davidwwhitney1-lgtm/disctracker/hardware/cad/renders/v_cover.png

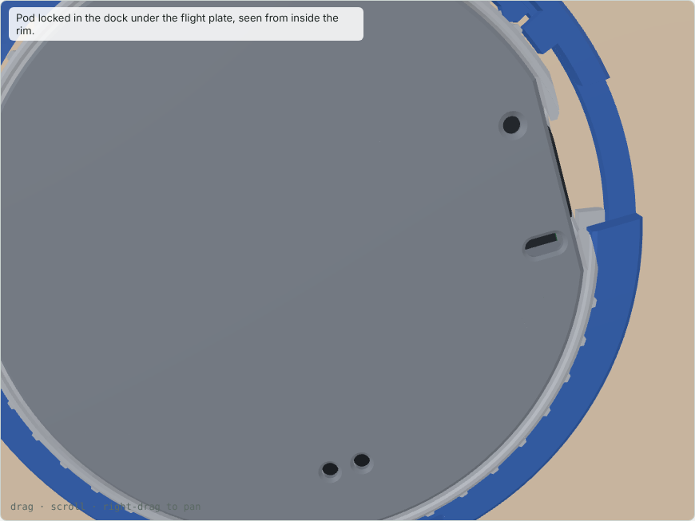
hardware/cad/renders/v_cover.png
