davidwwhitney1-lgtm/disctracker/hardware/cad/renders/v_exploded.png

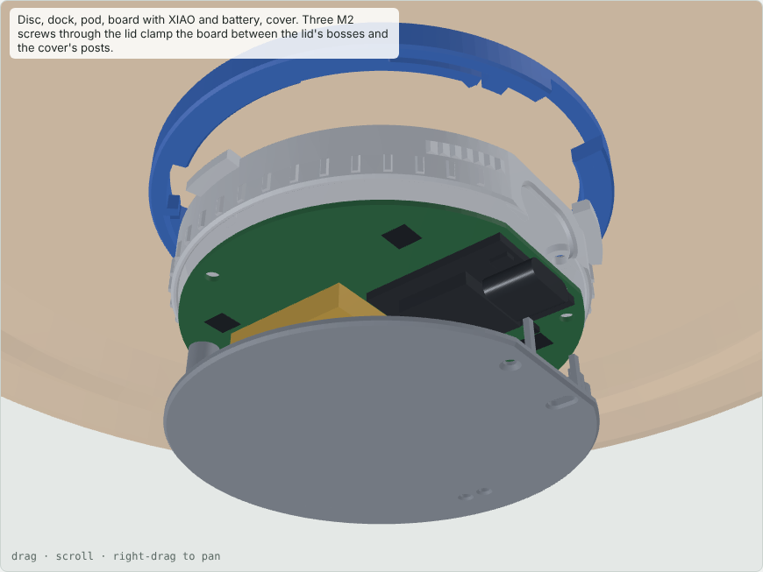
hardware/cad/renders/v_exploded.png
