davidwwhitney1-lgtm/disctracker/hardware/cad/renders/v_finger.png

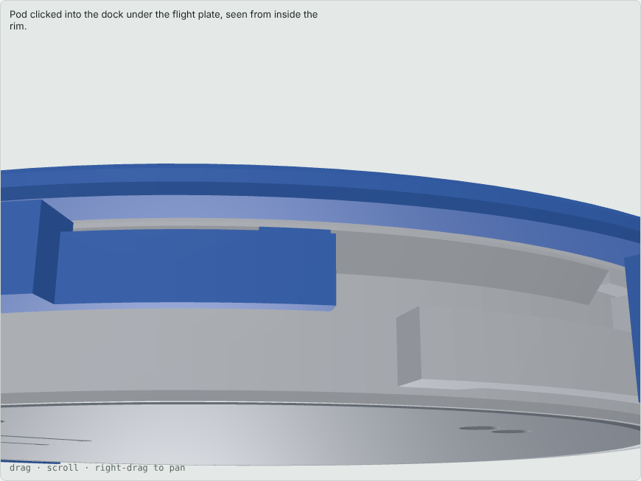
hardware/cad/renders/v_finger.png
