davidwwhitney1-lgtm/disctracker/hardware/cad/renders/v_jig.png

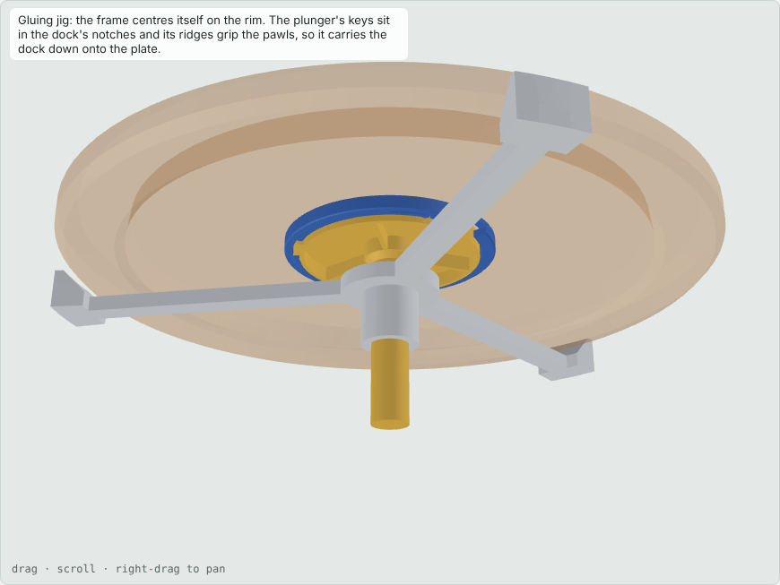
hardware/cad/renders/v_jig.png
