davidwwhitney1-lgtm/disctracker/hardware/cad/renders/v_latch.png

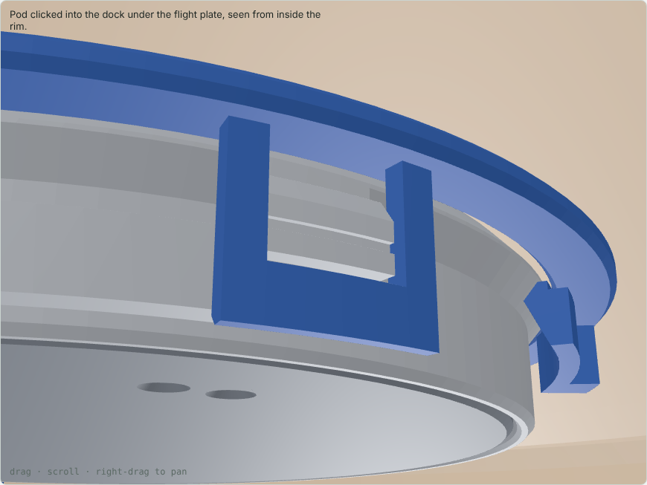
hardware/cad/renders/v_latch.png
