davidwwhitney1-lgtm/disctracker/hardware/cad/renders/v_lock.png

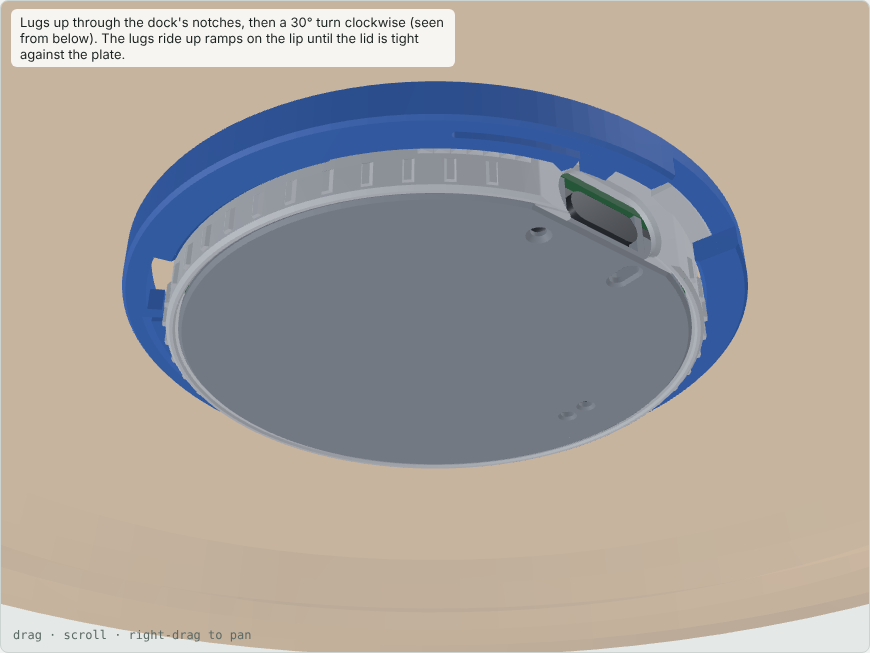
hardware/cad/renders/v_lock.png
