davidwwhitney1-lgtm/disctracker/hardware/cad/renders/v_lug_section.png

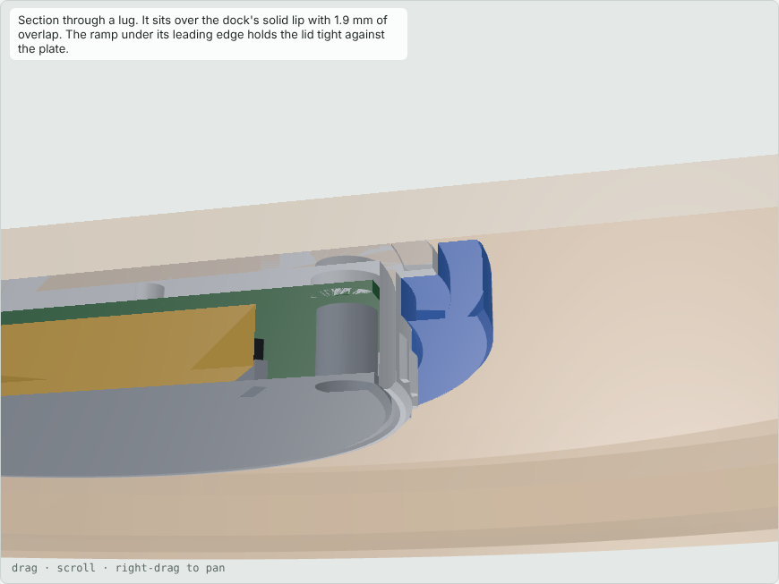
hardware/cad/renders/v_lug_section.png
