davidwwhitney1-lgtm/disctracker/hardware/cad/renders/v_reset_section.png

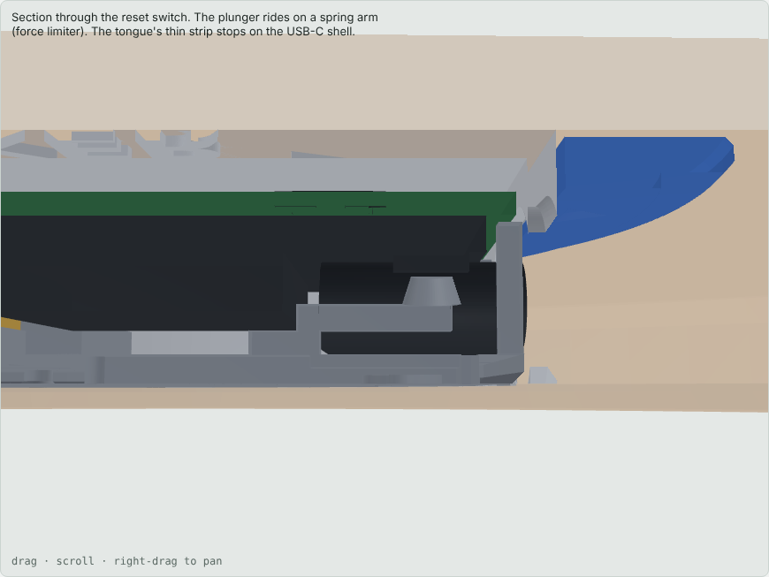
hardware/cad/renders/v_reset_section.png
