davidwwhitney1-lgtm/disctracker/hardware/cad/renders/v_usb_end.png

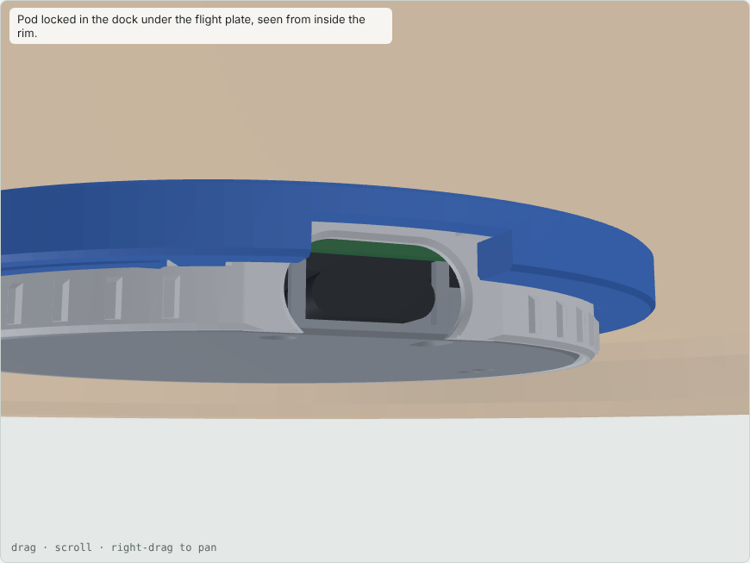
hardware/cad/renders/v_usb_end.png
