davidwwhitney1-lgtm/disctracker/hardware/cad/renders/v_usb_section.png

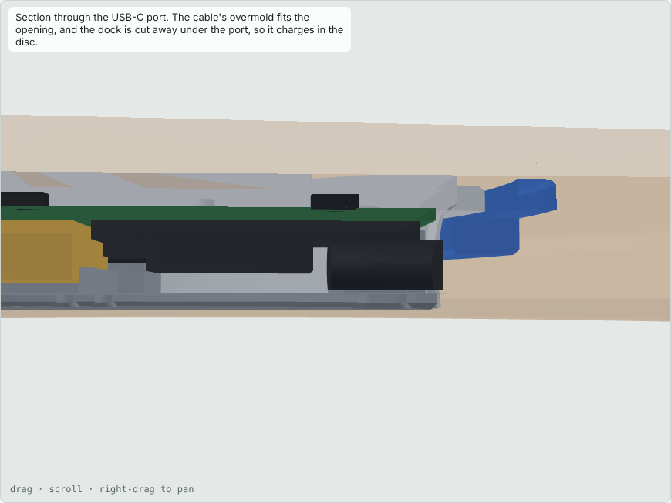
hardware/cad/renders/v_usb_section.png
