davidwwhitney1-lgtm/disctracker/hardware/kicad/fab/render_3d_bottom.png

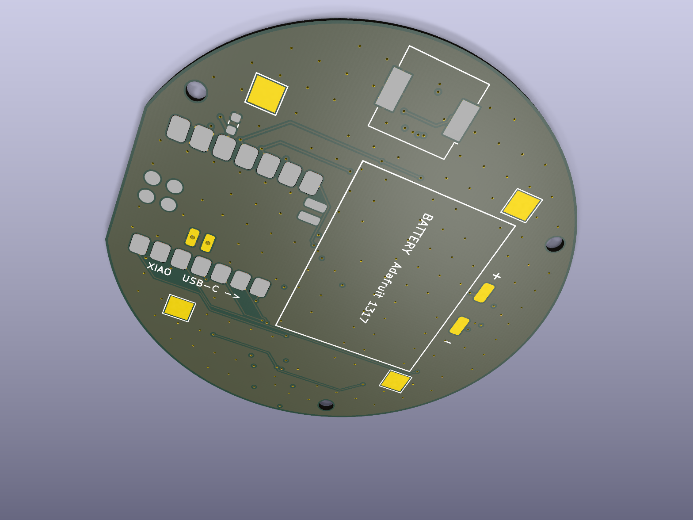
hardware/kicad/fab/render_3d_bottom.png
