davidwwhitney1-lgtm/disctracker/hardware/kicad/fab/render_3d_top.png

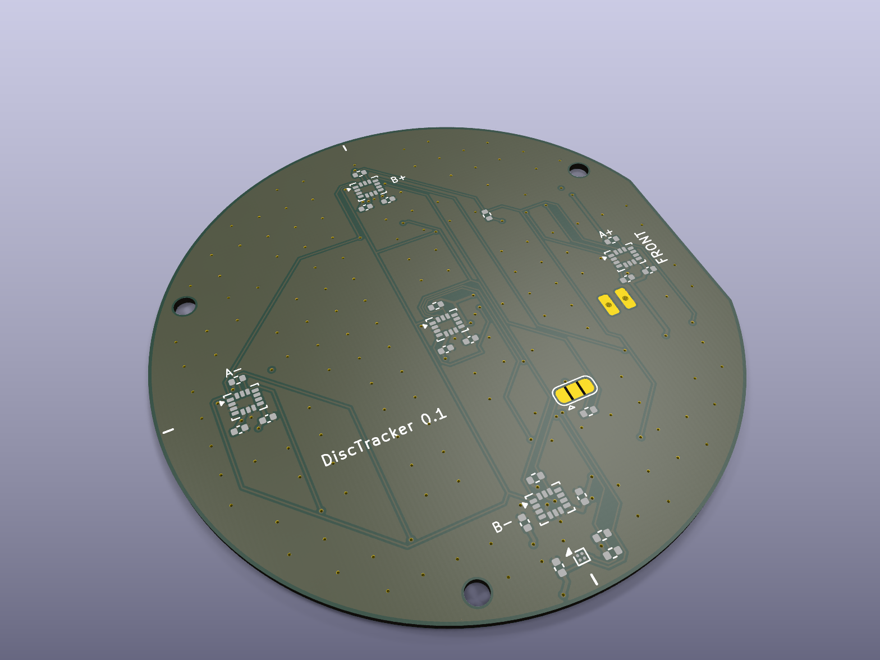
hardware/kicad/fab/render_3d_top.png
