davidwwhitney1-lgtm/disctracker/hardware/kicad/fab/render_sensor_face.png

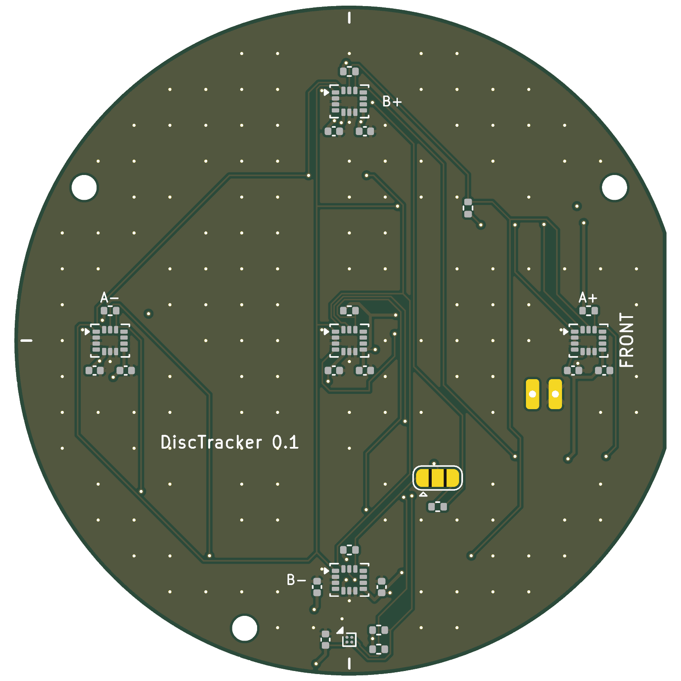
hardware/kicad/fab/render_sensor_face.png
