davidwwhitney1-lgtm/disctracker/hardware/kicad/fab/render_xiao_face.png

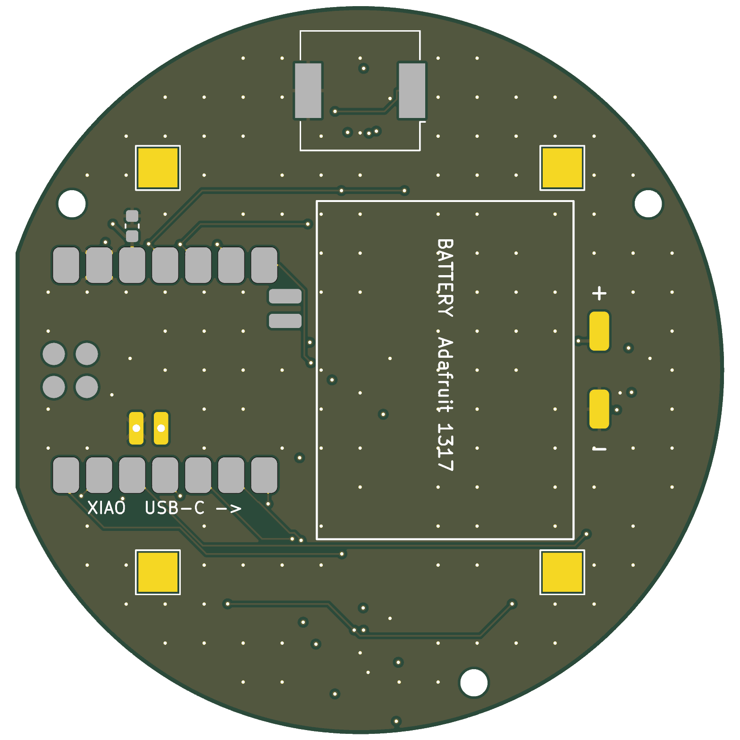
hardware/kicad/fab/render_xiao_face.png
