davidwwhitney1-lgtm/disctracker/hardware/bom.csv

Ref | Part | Value | Package | Qty | Populate | Face | Notes
U1 | ST LSM6DSV320X |  | LGA-14 2.5x3.0x0.83 | 1 | Yes | Sensor | Center IMU
U2 | ST LSM6DSV320X |  | LGA-14 2.5x3.0x0.83 | 1 | Yes | Sensor | Spin pair A (+20.00; 0)
U3 | ST LSM6DSV320X |  | LGA-14 2.5x3.0x0.83 | 1 | Yes | Sensor | Spin pair A (-20.00; 0)
U4 | ST LSM6DSV320X |  | LGA-14 2.5x3.0x0.83 | 1 | DNP | Sensor | Spin pair B (0; +20.00)
U5 | ST LSM6DSV320X |  | LGA-14 2.5x3.0x0.83 | 1 | DNP | Sensor | Spin pair B (0; -20.00)
U6 | MEMSIC MMC5603NJ |  | WLCSP 0.8x0.8 | 1 | Yes | Sensor | Magnetometer at (0; -24); JLCPCB C404328; I2C 0x30
C1-C10 | Capacitor | 100 nF | 0402 | 10 | 6 of 10 | Sensor | VDD (pin 8) + VDDIO (pin 5) per IMU; C7-C10 DNP with U4/U5
C11 | Capacitor | 2.2 uF | 0402 | 1 | Yes | Sensor | Magnetometer VDD (datasheet minimum 2.2 uF)
C12 | Capacitor | 10 uF | 0603 | 1 | Yes | XIAO | Bulk at XIAO 3V3
R1 R2 | Resistor | 4.7 k | 0402 | 2 | Yes | Sensor | I2C pull-ups (magnetometer)
R3 | Resistor | 33 R | 0402 | 1 | Yes | Sensor | Series on SPI clock
R4-R8 | Resistor | 100 k | 0402 | 5 | Yes | Sensor | CS pull-ups to 3V3 (firmware disables chips' internal pull-up with I2C_I3C_disable)
M1 | Seeed XIAO nRF52840 Sense |  | castellated SMD | 1 | Yes | XIAO | 2.027 g / 4.0 mm (measured); center (+15; 0) so USB-C reaches the pod edge; hand-soldered
BZ1 | CUI CPT-9019S-SMT-TR |  | 9x9x1.9 SMD | 1 | Yes | XIAO | Piezo 3 V / 5 mA / 65 dB @10 cm / 4 kHz; JLCPCB C95163; at (0; +21.5)
JP1 | 3-pad solder jumper |  | SMD | 1 | Yes | XIAO | D6 -> A: U5 CS / B: BZ1; ship bridged to B
R9 | Resistor | 100 R | 0402 | 1 | Yes | Sensor | Series to buzzer (limits peak current into piezo)
H1-H3 | Mounting hole | 2.1 mm | NPTH | 3 | - | Both | Alignment pins; r = 25.6 mm at 30/150/250 deg
BT1 | Adafruit 1317 LiPo 3.7 V (protected) | 150 mAh | 19.75x26.02x3.8 mm | 1 | Yes | XIAO | 4.65 g; center (-6.54; 0); bonded down; leads cut short to J1/J2; charge at 100 mA
J1 J2 | Battery pads |  | pads | 2 | Yes | XIAO | At (-18.4; +/-3); routed to XIAO BAT pads
TP1-TP4 | Balance trim pads | 3x3 mm | copper pad | 4 | Yes | XIAO | +X/-X/+Y/-Y; -Y opposite the buzzer; add solder to trim
