davidwwhitney1-lgtm/disctracker/hardware/kicad/fab/bom_jlc.csv

Comment | Designator | Footprint | LCSC Part #
100n | C1,C2,C3,C4,C5,C6 | C_0402_1005Metric | C1525
2.2u | C11 | C_0402_1005Metric | C12530
4.7k | R1,R2 | R_0402_1005Metric | C25900
33 | R3 | R_0402_1005Metric | C25105
100k | R4,R5,R6 | R_0402_1005Metric | C25741
100 | R9 | R_0402_1005Metric | C25076
LSM6DSV320X | U1,U2,U3 | LGA-14_3x2.5mm_P0.5mm_LayoutBorder3x4y
MMC5603NJ | U6 | WLP-4_0.86x0.86mm_P0.4mm | C404328
