davidwwhitney1-lgtm/disctracker/hardware/placement.csv

Ref | X_mm | Y_mm | Rotation | Face | Populate | Role
U1 | 0.00 | 0.00 | 0 | Sensor | Yes | Center IMU
U2 | 20.00 | 0.00 | 0 | Sensor | Yes | Pair A (+X)
U3 | -20.00 | 0.00 | 0 | Sensor | Yes | Pair A (-X)
U4 | 0.00 | 20.00 | 0 | Sensor | DNP | Pair B (+Y)
U5 | 0.00 | -20.00 | 0 | Sensor | DNP | Pair B (-Y)
U6 | 0.00 | -25.00 | 0 | Sensor | Yes | Magnetometer (moved 0.8 mm down for routing room; >=10 mm from XIAO and battery)
M1 | 15.00 | 0.00 | 0 | XIAO | Yes | XIAO (offset TBD by USB-C notch and balance)
BT1 | -6.54 | 0.00 | 0 | XIAO | Yes | Adafruit 1317 (19.75 in X x 26.02 in Y); balances XIAO 2.027 g at +15
J1 | -18.40 | 3.00 | 0 | XIAO | Yes | BAT+ pad
J2 | -18.40 | -3.00 | 0 | XIAO | Yes | BAT- pad
BZ1 | 0.00 | 21.50 | 0 | XIAO | Yes | Buzzer
TP1 | 0.00 | -21.50 | 0 | XIAO | Yes | Balance trim
C9 | 2.70 | -20.60 | 90 | Sensor | DNP | U5 VDD cap beside the chip (frees space for U6)
C10 | -2.70 | -20.60 | 90 | Sensor | DNP | U5 VDDIO cap beside the chip
H1-H3 | r=25.6 | 30/150/250 deg | - | Both | - | 2.1 mm NPTH alignment holes
TP1-TP4 | r=22 | 45/135/225/315 deg | - | XIAO | - | 3x3 mm balance trim pads
