davidwwhitney1-lgtm/disctracker/hardware/pinmap.csv

XIAO_pin | nRF_pin | Net | Goes_to | Notes
3V3 |  | +3V3 | IMU pin 8 VDD + pin 5 VDDIO; U6 B1; R1 R2 R4-R8; C12
GND |  | GND | IMU pins 6 7 + pins 2 SDx 3 SCx; U6 A1; plane
D8 | P1.13 | SPI_SCK | IMU pin 13 (SCL/SPC) via R3
D10 | P1.15 | SPI_MOSI | IMU pin 14 (SDA/SDI)
D9 | P1.14 | SPI_MISO | IMU pin 1 (SDO/TA0)
D0 | P0.02 | CS1 | U1 pin 12 | R4 100k pull-up
D1 | P0.03 | CS2 | U2 pin 12 | R5 100k pull-up
D2 | P0.28 | CS3 | U3 pin 12 | R6 100k pull-up
D3 | P0.29 | CS4 | U4 pin 12 | R7 100k pull-up; U4 DNP
D6 | P1.11 | CS5 / BUZZER | JP1: A -> U5 pin 12 / B -> BZ1 | R8 on U5 side; ship bridged to B
D7 | P1.12 | INT1 | U1 pin 4 | Data-ready
D4 | P0.04 | I2C_SDA | U6 B2 + R1
D5 | P0.05 | I2C_SCL | U6 A2 + R2
BAT+/BAT- |  | VBAT | XIAO underside BAT pads -> J1 J2 -> BT1
- |  | NC | IMU pins 9 INT2 / 10 OCS_aux / 11 SDO_aux | Soldered to pad; no connection (datasheet)
