davidwwhitney1-lgtm/disctracker/hardware/cad/out/housing_assembly.step

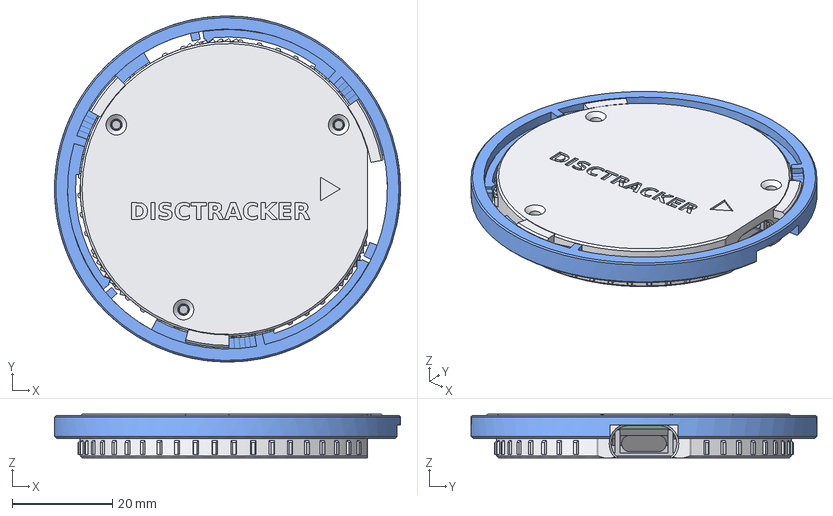
[picture p18: CAD file, 2026-10-14]
hardware/cad/out/housing_assembly.step
69.0 x 69.0 x 8.72 mm
dock
pod
cover
pcb
xiao
parts
battery
