davidwwhitney1-lgtm/disctracker/hardware/cad/out/jig_plunger.step

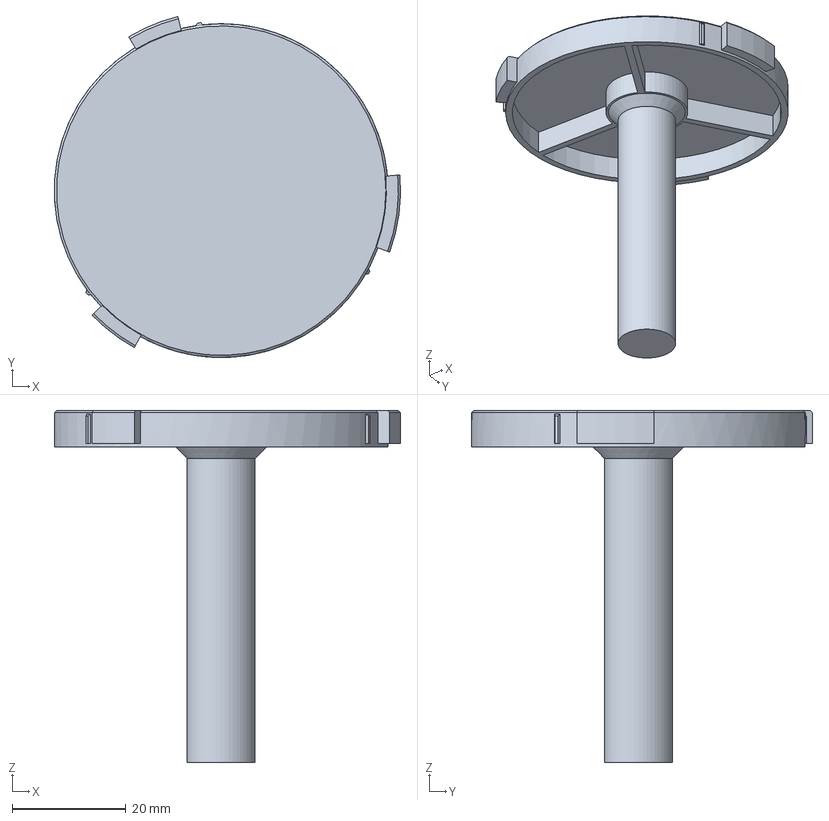
[picture p19: CAD file, 2026-10-14]
hardware/cad/out/jig_plunger.step
61.0 x 60.1 x 62.0 mm
