davidwwhitney1-lgtm/disctracker/hardware/cad/viewer/dock.stl

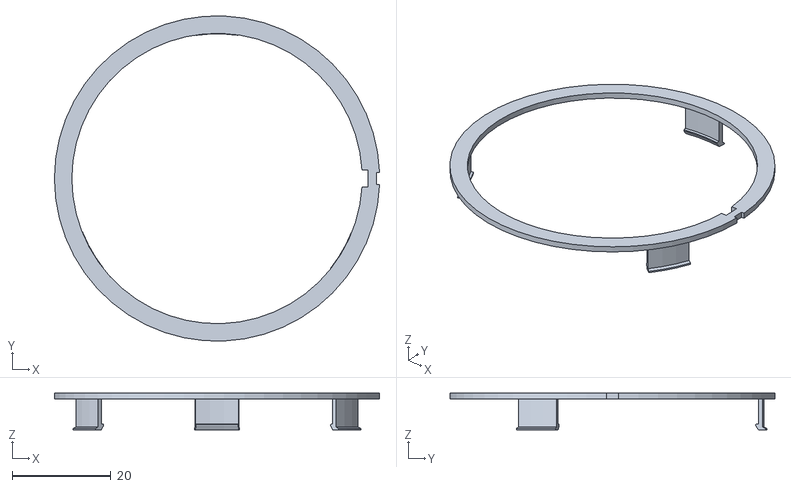
[picture p20: CAD file, 2026-10-10]
hardware/cad/viewer/dock.stl
66.0 x 65.9 x 7.50
