davidwwhitney1-lgtm/disctracker/hardware/kicad/fab/disctracker_sensor.step

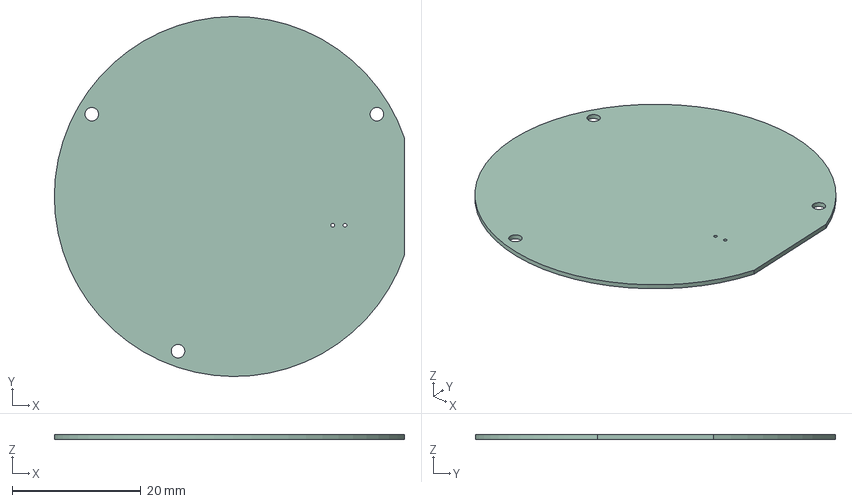
[picture p21: CAD file, 2026-10-09]
hardware/kicad/fab/disctracker_sensor.step
54.5 x 56.0 x 0.71 mm
