davidwwhitney1-lgtm/disctracker/hardware/cad/out/pod.step

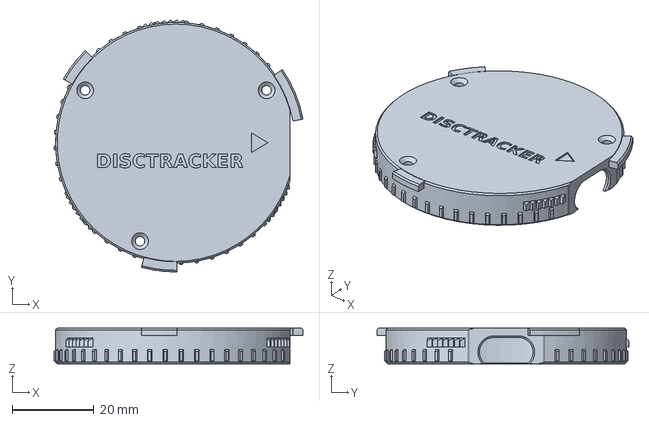
[picture p22: CAD file, 2026-10-14]
hardware/cad/out/pod.step
60.9 x 61.6 x 8.72 mm
