davidwwhitney1-lgtm/disctracker/hardware/cad/viewer/pod.stl

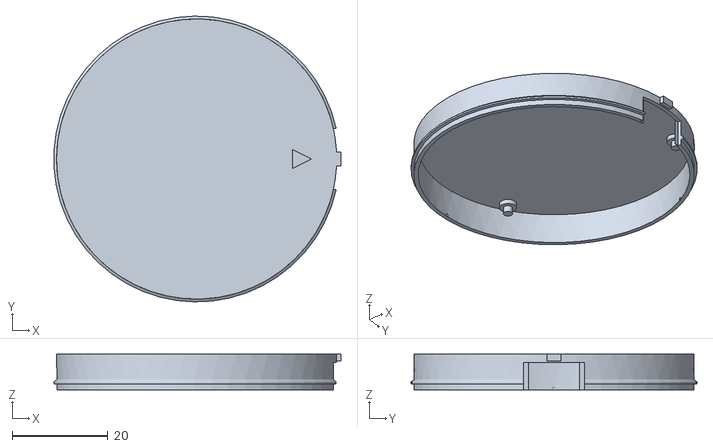
[picture p23: CAD file, 2026-10-10]
hardware/cad/viewer/pod.stl
59.8 x 59.6 x 7.50
