davidwwhitney1-lgtm/disctracker/hardware/cad/out/test_ring.step

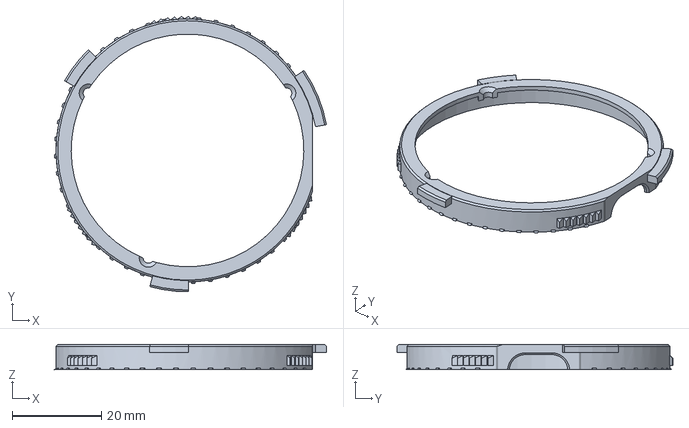
[picture p24: CAD file, 2026-10-14]
hardware/cad/out/test_ring.step
60.8 x 61.6 x 5.60 mm
