davidwwhitney1-lgtm/disctracker/hardware/cad/viewer/cover.stl

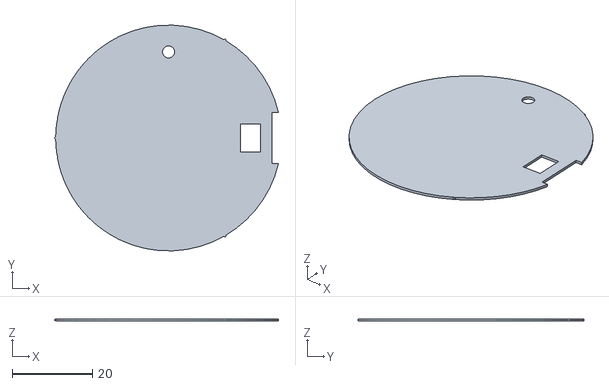
[picture p25: CAD file, 2026-10-10]
hardware/cad/viewer/cover.stl
56.0 x 56.4 x 0.6
