davidwwhitney1-lgtm/disctracker/hardware/cad/out/dock.step

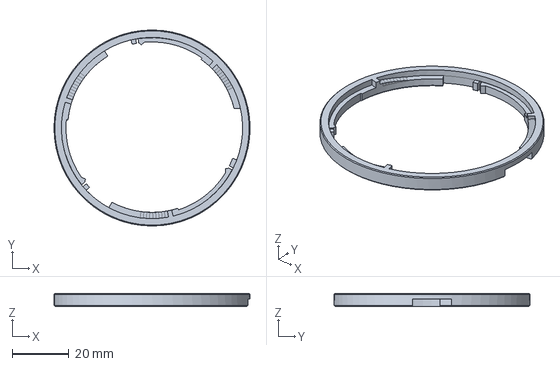
[picture p26: CAD file, 2026-10-14]
hardware/cad/out/dock.step
69.0 x 69.0 x 4.60 mm
