davidwwhitney1-lgtm/disctracker/hardware/cad/viewer/pcb_parts_dummy.stl

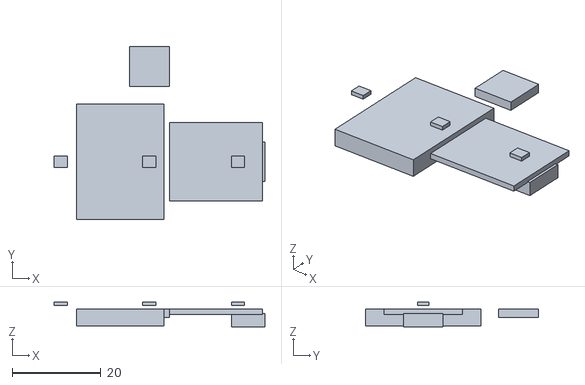
[picture p27: CAD file, 2026-10-10]
hardware/cad/viewer/pcb_parts_dummy.stl
47.6 x 39.0 x 5.63
