davidwwhitney1-lgtm/disctracker/hardware/cad/out/cover.step

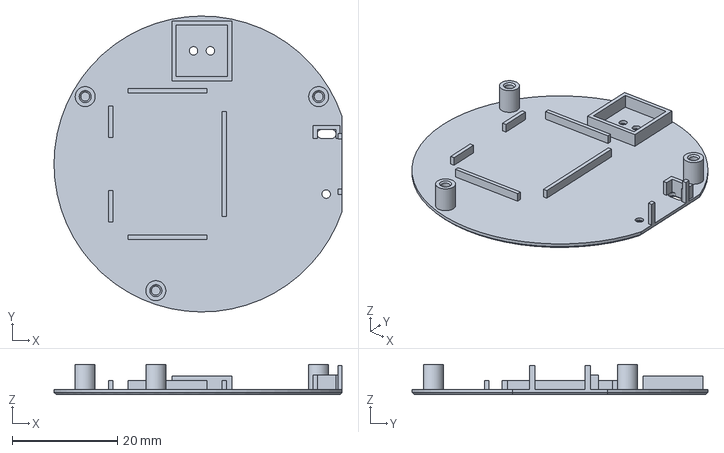
[picture p28: CAD file, 2026-10-14]
hardware/cad/out/cover.step
54.7 x 56.2 x 5.76 mm
