davidwwhitney1-lgtm/disctracker/hardware/cad/viewer/pcb_dummy.stl

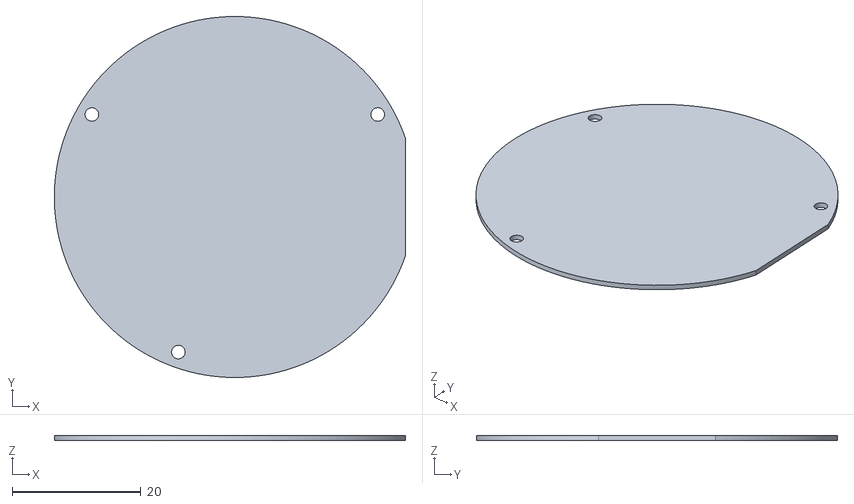
[picture p29: CAD file, 2026-10-10]
hardware/cad/viewer/pcb_dummy.stl
54.5 x 56.0 x 0.8
