davidwwhitney1-lgtm/disctracker/hardware/cad/out/jig_frame.step

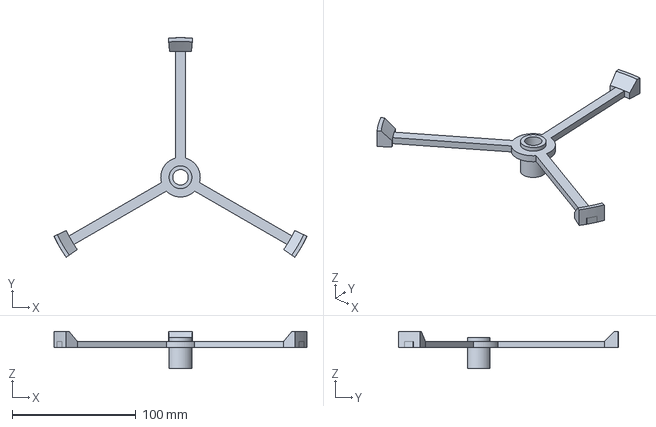
[picture p30: CAD file, 2026-10-14]
hardware/cad/out/jig_frame.step
204.8 x 177.8 x 30.0 mm
