davidwwhitney1-lgtm/disctracker/hardware/cad/out/ref_parts.stl

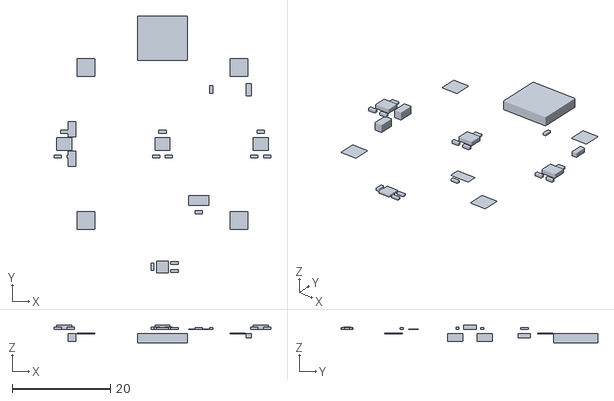
[picture p31: CAD file, 2026-10-11]
hardware/cad/out/ref_parts.stl
44.1 x 52.3 x 3.56
