davidwwhitney1-lgtm/disctracker/hardware/cad/out/ref_disc.stl

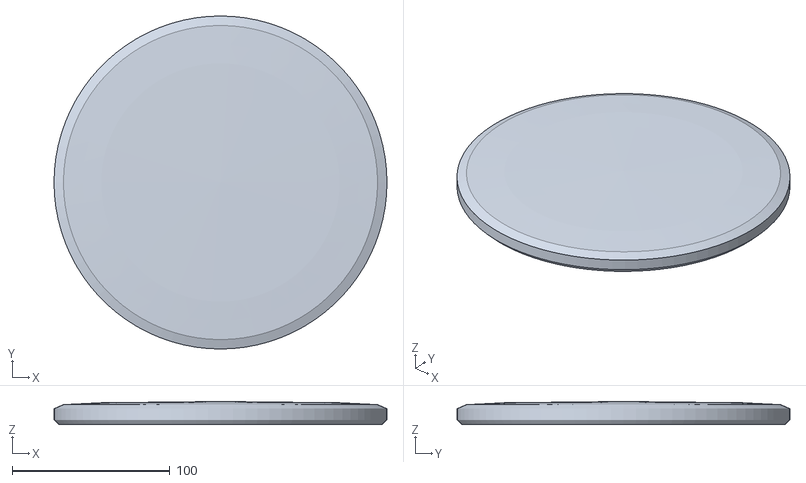
[picture p32: CAD file, 2026-10-11]
hardware/cad/out/ref_disc.stl
211.0 x 211.0 x 14.6
