davidwwhitney1-lgtm/disctracker/hardware/cad/out/ref_battery.stl

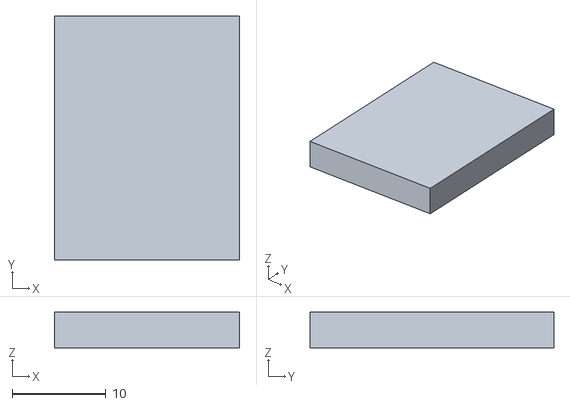
[picture p33: CAD file, 2026-10-11]
hardware/cad/out/ref_battery.stl
19.8 x 26.0 x 3.80
