davidwwhitney1-lgtm/disctracker/hardware/cad/out/ref_xiao.stl

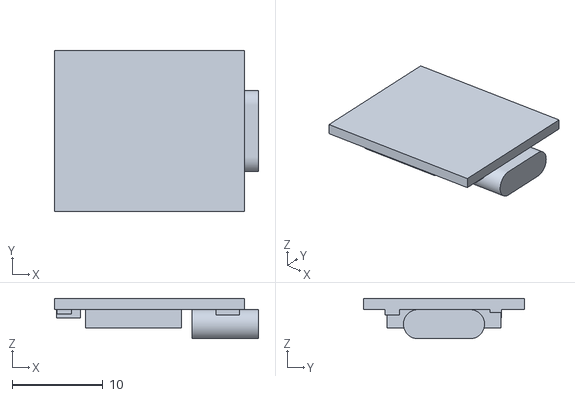
[picture p34: CAD file, 2026-10-11]
hardware/cad/out/ref_xiao.stl
22.5 x 17.8 x 4.46
