davidwwhitney1-lgtm/disctracker/hardware/cad/out/jig.step

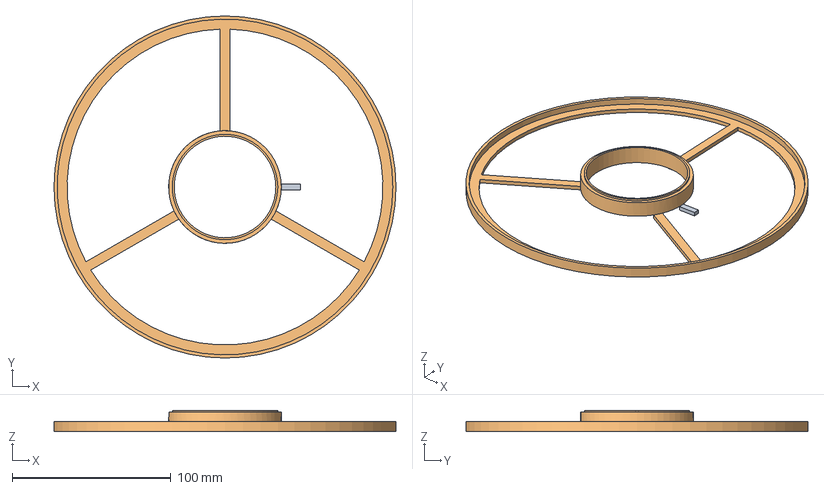
[picture p35: CAD file, 2026-10-10]
hardware/cad/out/jig.step
215.5 x 215.5 x 13.5 mm
