davidwwhitney1-lgtm/disctracker/(list of files, cad)

Other CAD files:
hardware/cad/out/ref_board.stl
hardware/cad/out/cover.stl
hardware/cad/out/dock.stl
hardware/cad/out/jig.stl
hardware/cad/out/jig_frame.stl
hardware/cad/out/jig_plunger.stl
hardware/cad/out/pod.stl
hardware/cad/out/test_ring.stl
