davidwwhitney1-lgtm/disctracker/hardware/cad/renders/v_assembled.png

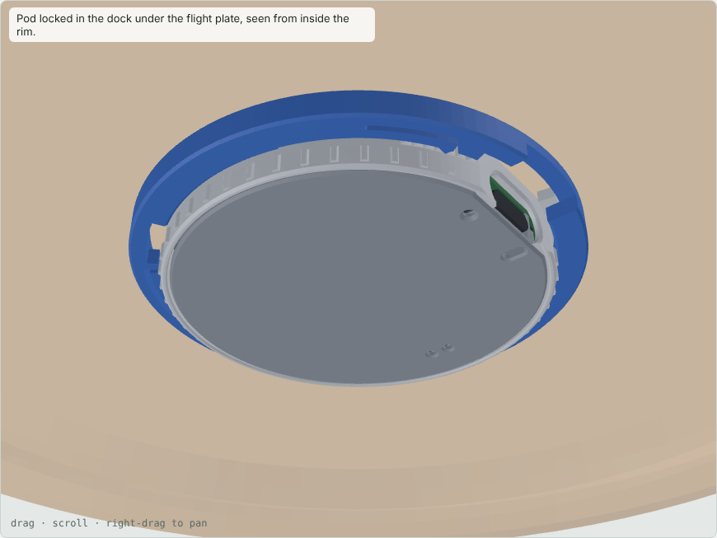
hardware/cad/renders/v_assembled.png
