davidwwhitney1-lgtm/disctracker/hardware/kicad/disctracker_sensor.pdf

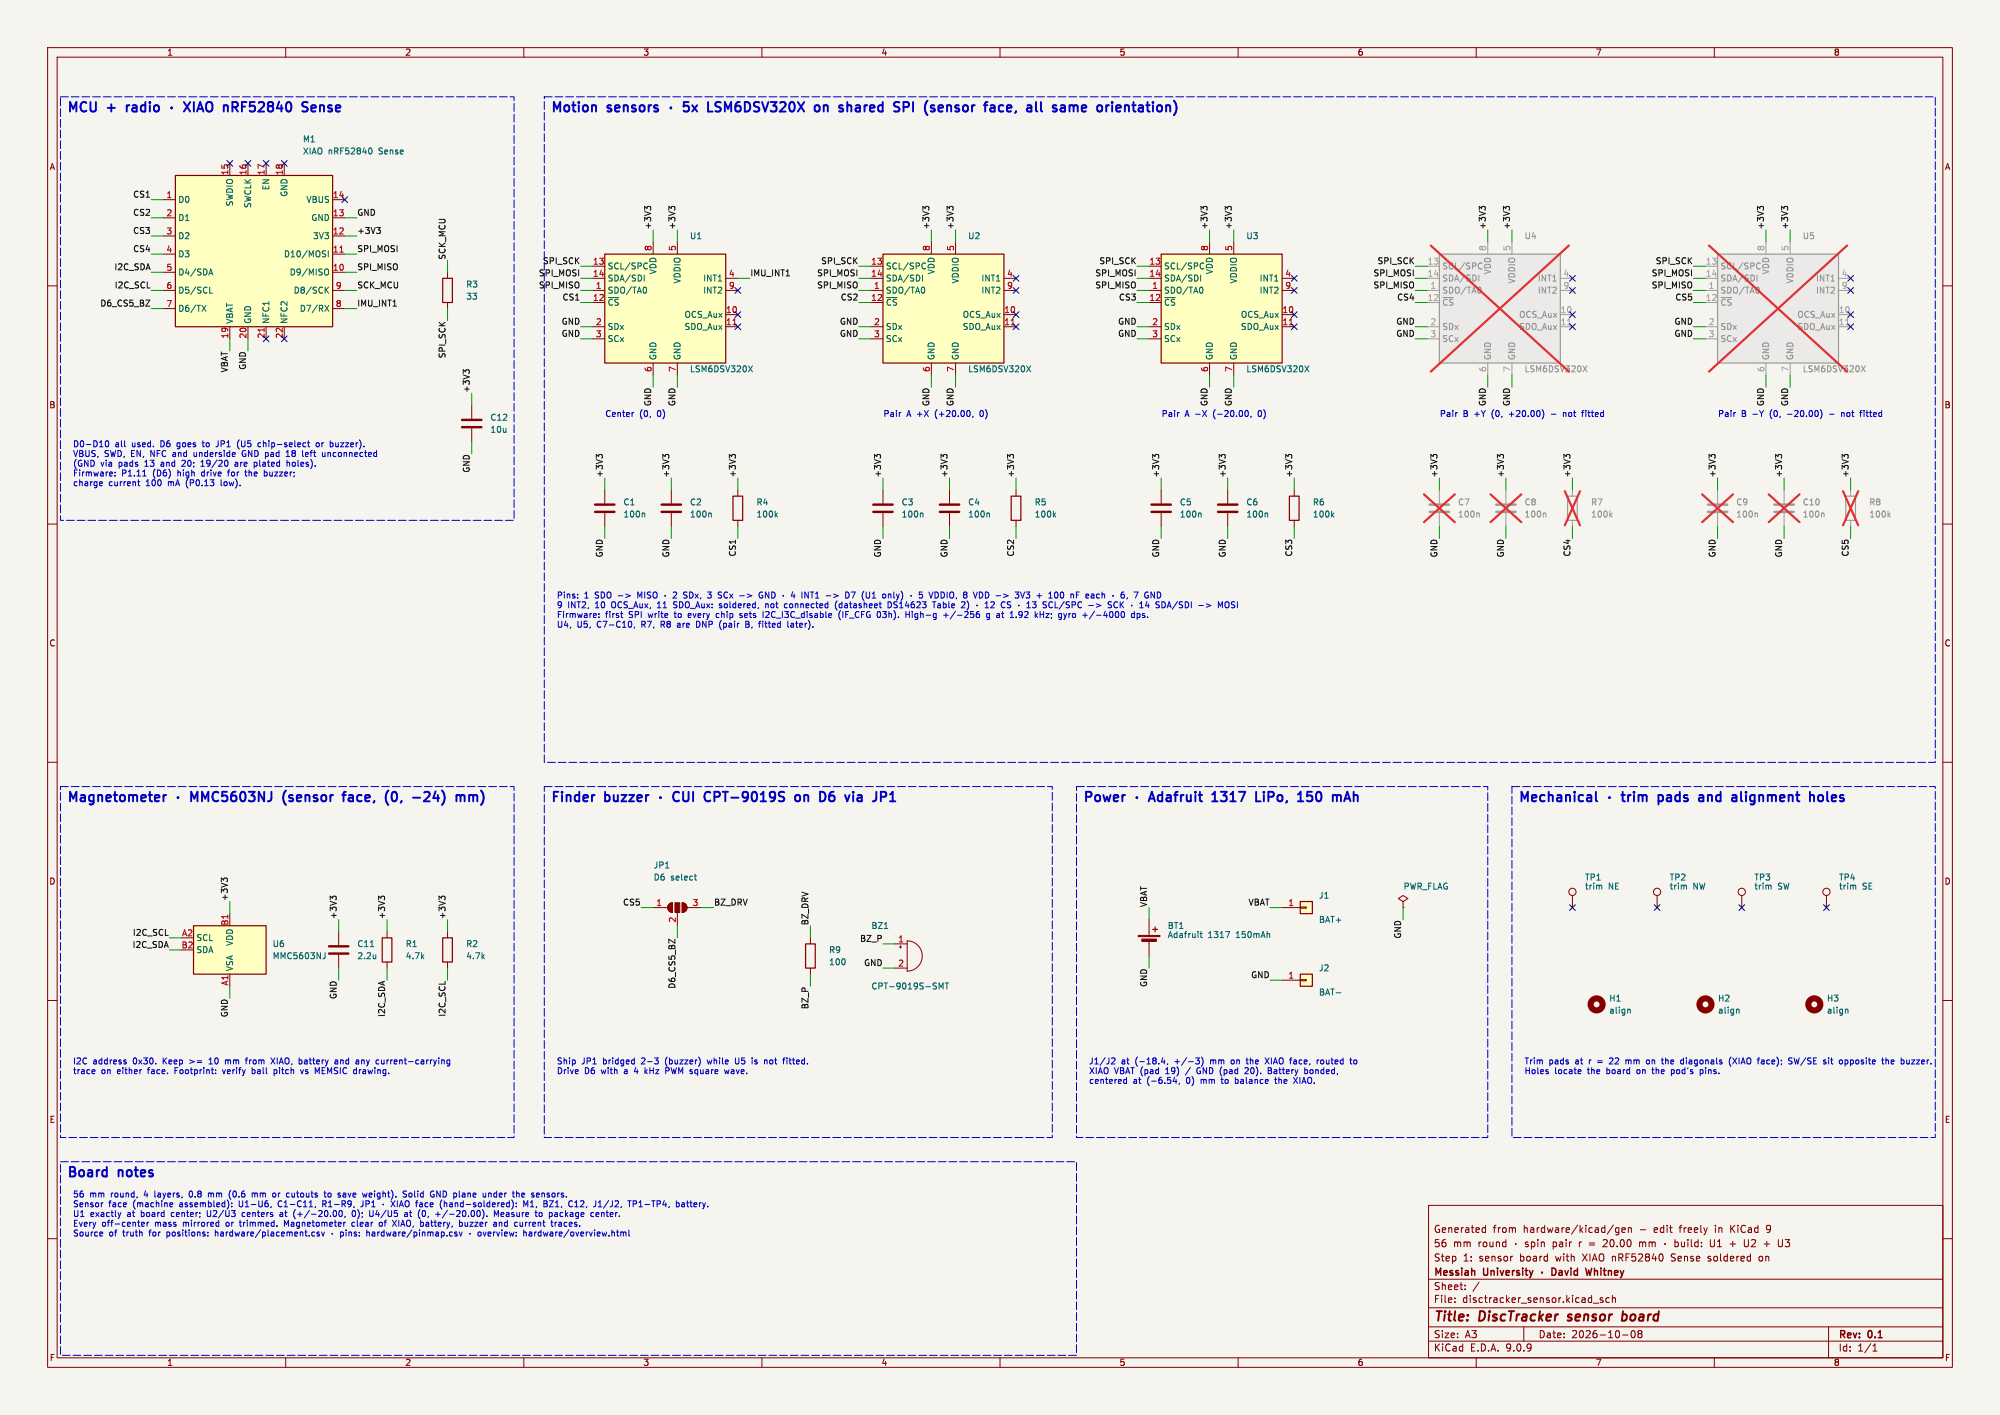
[picture p37: page 1]

Power þÿ·Adafruit 1317 LiPo, 150 mAh

I2C address 0x30. Keep >= 10 mm from XIAO, battery and any current-carrying

Id: 1/1 Title: DiscTracker sensor board
