davidwwhitney1-lgtm/disctracker/hardware/kicad/disctracker_sensor.kicad_pcb

## KiCad design hardware/kicad/disctracker_sensor.kicad_pcb (2026-10-09)

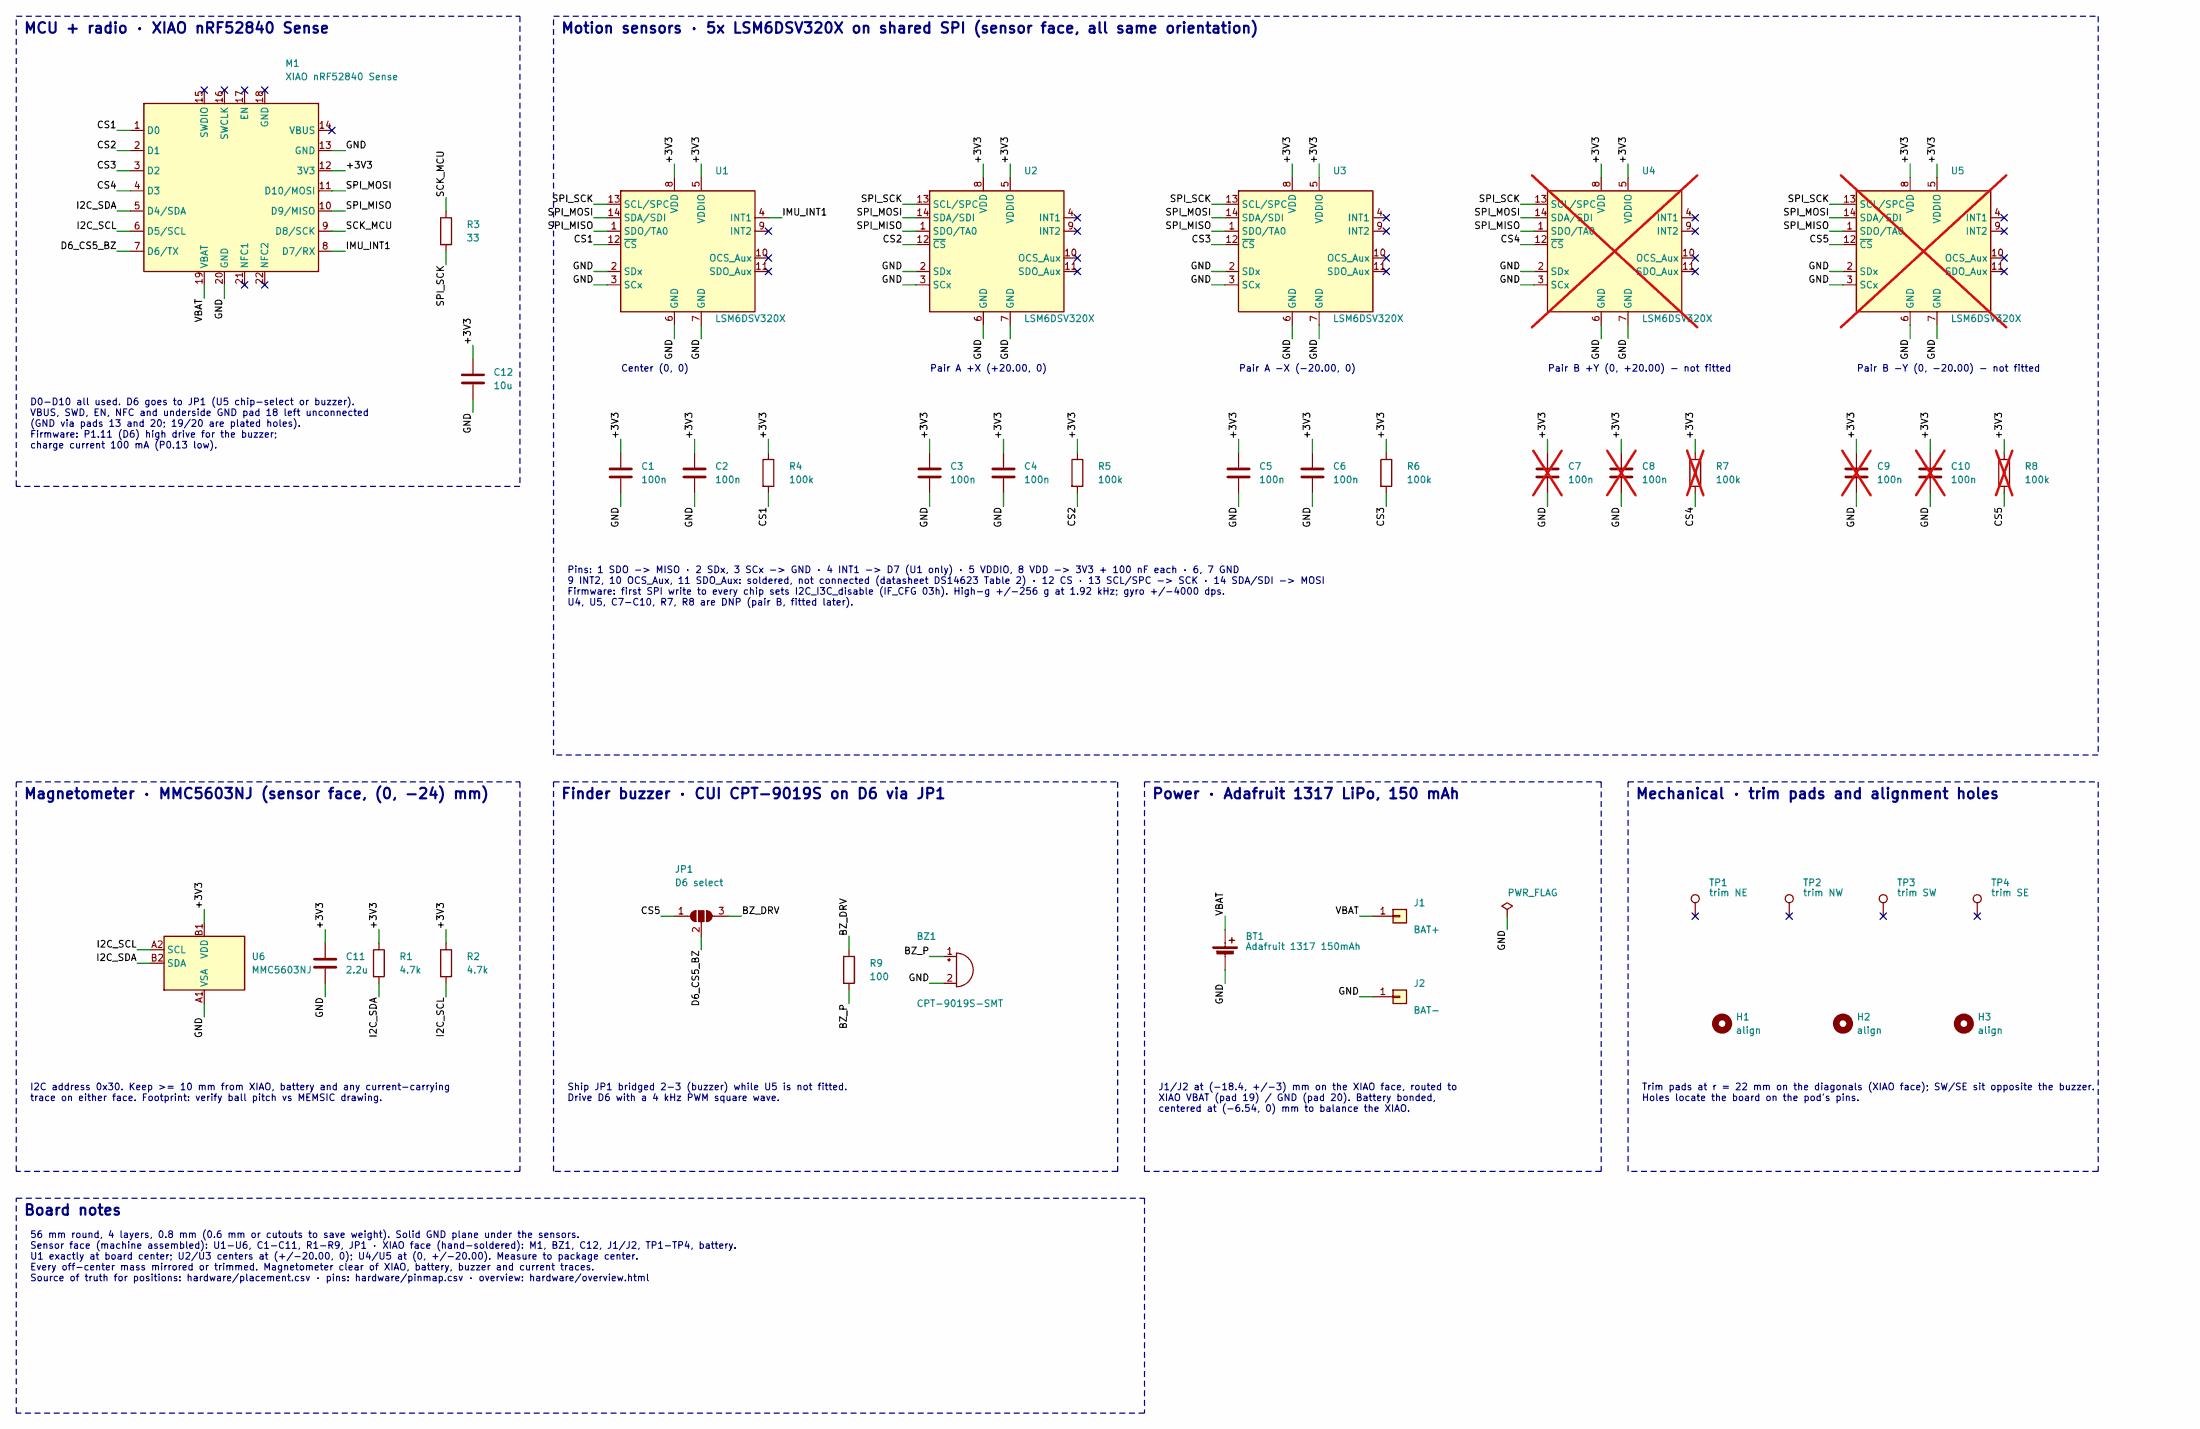
[picture p38: schematic disctracker_sensor.kicad_sch, DiscTracker sensor board]

Parts:
BT1: Adafruit 1317 150mAh; MPN Adafruit 1317
BZ1: CPT-9019S-SMT; Buzzer_CUI_CPT-9019S-SMT; MPN CPT-9019S-SMT-TR; LCSC C95163
C1, C2, C3, C4, C5, C6: 100n; C_0402_1005Metric
C7, C8, C9, C10: 100n; C_0402_1005Metric; not fitted
C11: 2.2u; C_0402_1005Metric
C12: 10u; C_0603_1608Metric
H1, H2, H3: align; MountingHole_2.1mm
J1: BAT+; SolderWirePad_1x01_SMD_1.5x3mm
J2: BAT-; SolderWirePad_1x01_SMD_1.5x3mm
JP1: D6 select; SolderJumper-3_P1.3mm_Open_RoundedPad1.0x1.5mm
M1: XIAO nRF52840 Sense; XIAO-nRF52840-SMD; MPN Seeed 102010469
R1, R2: 4.7k; R_0402_1005Metric
R3: 33; R_0402_1005Metric
R4, R5, R6: 100k; R_0402_1005Metric
R7, R8: 100k; R_0402_1005Metric; not fitted
R9: 100; R_0402_1005Metric
TP1: trim NE; TestPoint_Pad_3.0x3.0mm
TP2: trim NW; TestPoint_Pad_3.0x3.0mm
TP3: trim SW; TestPoint_Pad_3.0x3.0mm
TP4: trim SE; TestPoint_Pad_3.0x3.0mm
U1, U2, U3: LSM6DSV320X; LGA-14_3x2.5mm_P0.5mm_LayoutBorder3x4y; MPN LSM6DSV320XTR
U4, U5: LSM6DSV320X; LGA-14_3x2.5mm_P0.5mm_LayoutBorder3x4y; MPN LSM6DSV320XTR; not fitted
U6: MMC5603NJ; WLP-4_0.86x0.86mm_P0.4mm; MPN MMC5603NJ; LCSC C404328

Connections:
/+3V3: C1.1, C2.1, C3.1, C4.1, C5.1, C6.1, C7.1, C8.1, C9.1, C10.1, C11.1, C12.1, M1.12 (3V3), R1.1, R2.1, R4.1, R5.1, R6.1, R7.1, R8.1, U1.5 (VDDIO), U1.8 (VDD), U2.5 (VDDIO), U2.8 (VDD), U3.5 (VDDIO), U3.8 (VDD), U4.5 (VDDIO), U4.8 (VDD), U5.5 (VDDIO), U5.8 (VDD), U6.B1 (VDD)
/BZ_DRV: JP1.3 (B), R9.1
/BZ_P: BZ1.1 (+), R9.2
/CS1: M1.1 (D0), R4.2, U1.12 (~CS)
/CS2: M1.2 (D1), R5.2, U2.12 (~CS)
/CS3: M1.3 (D2), R6.2, U3.12 (~CS)
/CS4: M1.4 (D3), R7.2, U4.12 (~CS)
/CS5: JP1.1 (A), R8.2, U5.12 (~CS)
/D6_CS5_BZ: JP1.2 (C), M1.7 (D6/TX)
/GND: BT1.2 (-), BZ1.2 (-), C1.2, C2.2, C3.2, C4.2, C5.2, C6.2, C7.2, C8.2, C9.2, C10.2, C11.2, C12.2, J2.1, M1.13 (GND), M1.20 (GND), U1.2 (SDx), U1.3 (SCx), U1.6 (GND), U1.7 (GND), U2.2 (SDx), U2.3 (SCx), U2.6 (GND), U2.7 (GND), U3.2 (SDx), U3.3 (SCx), U3.6 (GND), U3.7 (GND), U4.2 (SDx), U4.3 (SCx), U4.6 (GND), U4.7 (GND), U5.2 (SDx), U5.3 (SCx), U5.6 (GND), U5.7 (GND), U6.A1 (VSA)
/I2C_SCL: M1.6 (D5/SCL), R2.2, U6.A2 (SCL)
/I2C_SDA: M1.5 (D4/SDA), R1.2, U6.B2 (SDA)
/IMU_INT1: M1.8 (D7/RX), U1.4 (INT1)
/SCK_MCU: M1.9 (D8/SCK), R3.1
/SPI_MISO: M1.10 (D9/MISO), U1.1 (SDO/TA0), U2.1 (SDO/TA0), U3.1 (SDO/TA0), U4.1 (SDO/TA0), U5.1 (SDO/TA0)
/SPI_MOSI: M1.11 (D10/MOSI), U1.14 (SDA/SDI), U2.14 (SDA/SDI), U3.14 (SDA/SDI), U4.14 (SDA/SDI), U5.14 (SDA/SDI)
/SPI_SCK: R3.2, U1.13 (SCL/SPC), U2.13 (SCL/SPC), U3.13 (SCL/SPC), U4.13 (SCL/SPC), U5.13 (SCL/SPC)
/VBAT: BT1.1 (+), J1.1, M1.19 (VBAT)

Notes on the sheet:
MCU + radio · XIAO nRF52840 Sense
D0-D10 all used. D6 goes to JP1 (U5 chip-select or buzzer). VBUS, SWD, EN, NFC and underside GND pad 18 left unconnected (GND via pads 13 and 20; 19/20 are plated holes). Firmware: P1.11 (D6) high drive for the buzzer; charge current 100 mA (P0.13 low).
Motion sensors · 5x LSM6DSV320X on shared SPI (sensor face, all same orientation)
Center (0, 0)
Pair A +X (+20.00, 0)
Pair A -X (-20.00, 0)
Pair B +Y (0, +20.00) - not fitted
Pair B -Y (0, -20.00) - not fitted
Pins: 1 SDO -> MISO · 2 SDx, 3 SCx -> GND · 4 INT1 -> D7 (U1 only) · 5 VDDIO, 8 VDD -> 3V3 + 100 nF each · 6, 7 GND 9 INT2, 10 OCS_Aux, 11 SDO_Aux: soldered, not connected (datasheet DS14623 Table 2) · 12 CS · 13 SCL/SPC -> SCK · 14 SDA/SDI -> MOSI Firmware: first SPI write to every chip sets I2C_I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
Magnetometer · MMC5603NJ (sensor face, (0, -24) mm)
I2C address 0x30. Keep >= 10 mm from XIAO, battery and any current-carrying trace on either face. Footprint: verify ball pitch vs MEMSIC drawing.
Finder buzzer · CUI CPT-9019S on D6 via JP1
Ship JP1 bridged 2-3 (buzzer) while U5 is not fitted. Drive D6 with a 4 kHz PWM square wave.
Power · Adafruit 1317 LiPo, 150 mAh
J1/J2 at (-18.4, +/-3) mm on the XIAO face, routed to XIAO VBAT (pad 19) / GND (pad 20). Battery bonded, centered at (-6.54, 0) mm to balance the XIAO.
Mechanical · trim pads and alignment holes
Trim pads at r = 22 mm on the diagonals (XIAO face); SW/SE sit opposite the buzzer. Holes locate the board on the pod's pins.
Board notes
56 mm round, 4 layers, 0.8 mm (0.6 mm or cutouts to save weight). Solid GND plane under the sensors. Sensor face (machine assembled): U1-U6, C1-C11, R1-R9, JP1 · XIAO face (hand-soldered): M1, BZ1, C12, J1/J2, TP1-TP4, battery. U1 exactly at board center; U2/U3 centers at (+/-20.00, 0); U4/U5 at (0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

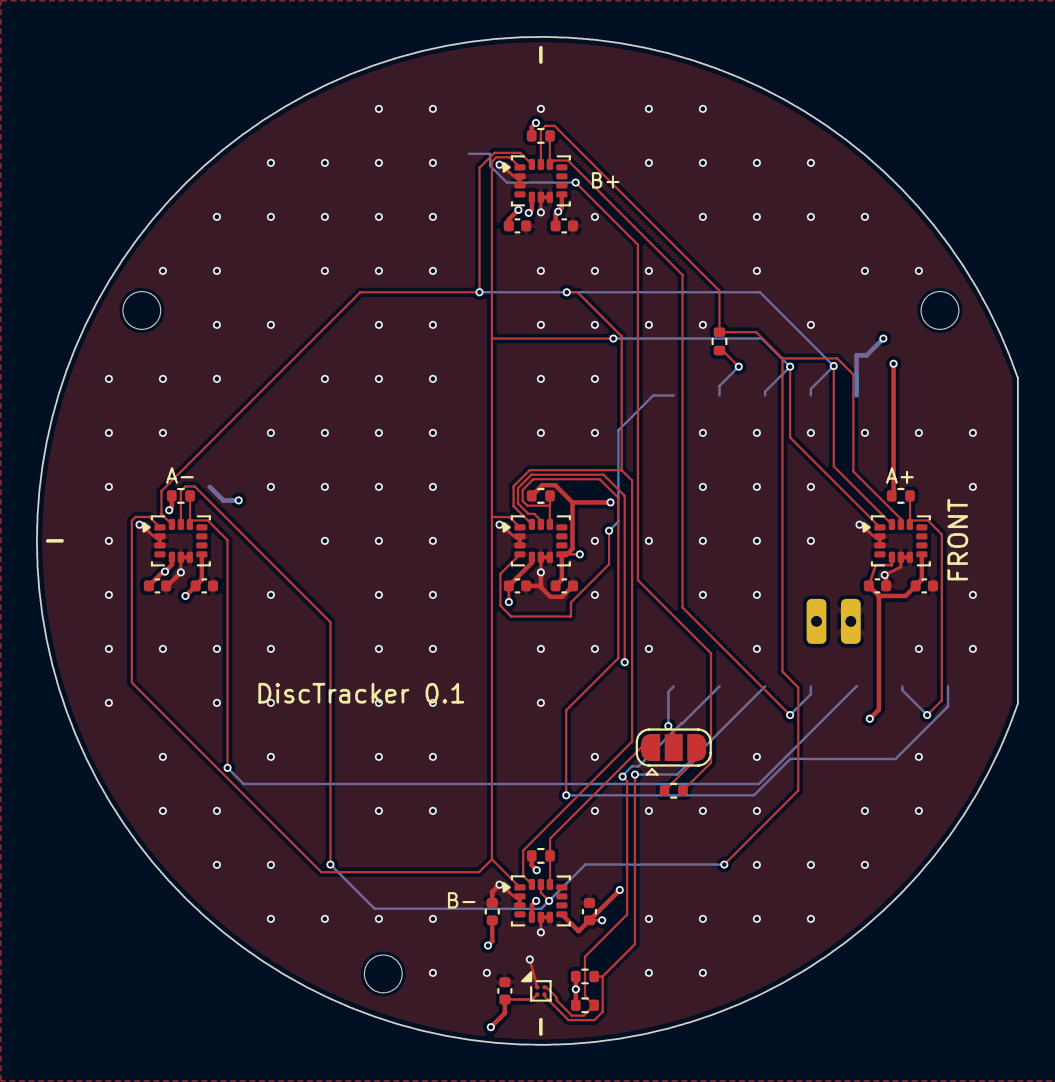
[picture p39: board disctracker_sensor.kicad_pcb from above]

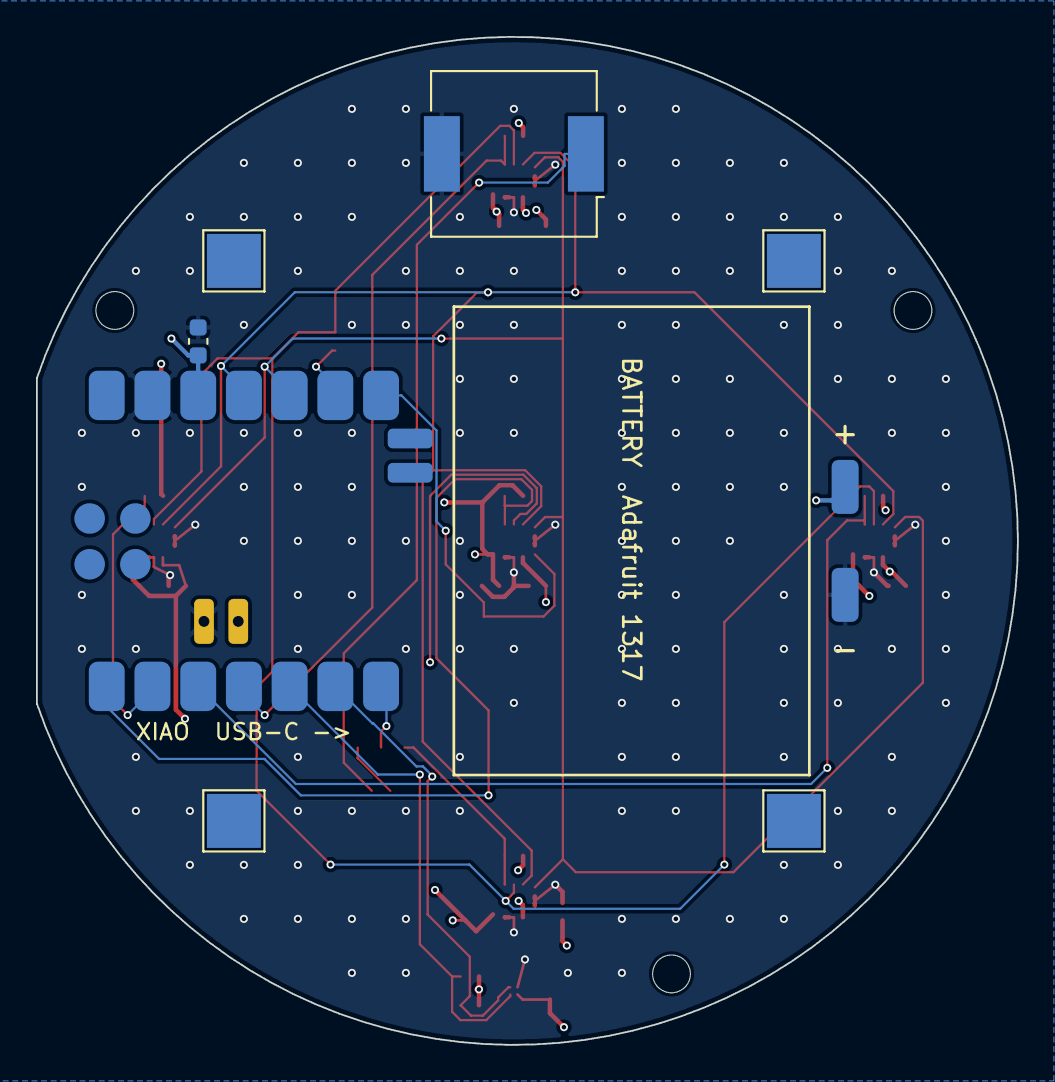
[picture p40: board disctracker_sensor.kicad_pcb from below]

Board: 4 copper layers, 54.5 x 56.0 mm, 39 parts (9 on the bottom side), 18 nets.
