davidwwhitney1-lgtm/disctracker/(commit log)

2026-10-05 3D disc view: no tilt clamp, visible underside, spin animation, dim while moving
2026-10-05 Calibrate card, speed first, rejected-throw notice, battery, endless auto-reconnect
2026-10-05 Power card: standby, wake, turn off (flick to wake)
2026-10-07 Find my disc (hot/cold, direction scan, distance calibration, beeps, LED) and throw sensitivity bar
2026-10-07 Throw data / Simulate tabs, flight simulator, disc bag, wind; demo removed; pressed-button feedback; spin direction
2026-10-07 Live 3D disc: filtered attitude, fixed mirrored roll, USB-C front, CSV export for verification
2026-10-07 Spin above 333 rpm: phase-fit drag wave + centripetal estimate, live estimate, spin calibration
2026-10-08 Full sensor recording card with test markers in Calibrate & test
2026-10-08 Add project context handoff doc (PCB plan, firmware, findings)
2026-10-08 Add hardware/ folder organizing the custom sensor PCB (BOM, placement, pin map, KiCad plan)
    Claude-Session: https://claude.ai/code/session_013WWMZni5TrjV9cuQFT1N1C
    [bom.csv, pinmap.csv, placement.csv]
2026-10-08 Hardware: lock 48 mm board and D6 buzzer, datasheet findings, wiring/layout/housing overview
    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
    [bom.csv, pinmap.csv]
2026-10-08 Hardware rev 2: wider 56 mm board, dock + pod housing, LSM6DSV320X pinout from datasheet, buzzer part
    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
    [bom.csv, pinmap.csv, placement.csv]
2026-10-08 Hardware: battery options with balance math; record measured XIAO mass/height
    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
2026-10-08 Hardware: battery runtime estimates
    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
2026-10-08 Hardware: choose Adafruit 1317 battery, place it at -6.5 mm to balance the XIAO
    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
    [bom.csv, placement.csv]
2026-10-08 Add KiCad 9 schematic for the sensor board (ERC clean)
    Single A3 sheet: XIAO nRF52840 Sense, 5x LSM6DSV320X on SPI (U4/U5 DNP),
    MMC5603NJ on I2C, CPT-9019S buzzer on D6 via JP1, battery pads, trim pads
    and alignment holes. Custom symbols for LSM6DSV320X, MMC5603NJ and the XIAO;
    XIAO SMD footprint from Seeed's OPL library (CC BY-SA 4.0). Includes PDF,
    KiCad BOM export and the generator script.
    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
    [bom.csv, bom_kicad.csv, disctracker_sensor.kicad_sch]
2026-10-09 Add routed 4-layer PCB layout and JLCPCB fab files for the sensor board
    56 mm round board, sensors on top (machine assembled), XIAO + battery + buzzer
    on the bottom. In1 is a solid GND plane, In2 a +3V3 pour; Freerouting on the
    signal layers, locked GND fan-out under each IMU, GND stitching vias. DRC is
    clean with schematic parity (0 violations, 0 unconnected). XIAO VBAT/GND
    underside pads become plated holes; its pad 18 is now left unconnected in the
    schematic. Gerbers, drills, JLC BOM/CPL, STEP and renders in kicad/fab.
    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
    [bom_all.csv, bom_jlc.csv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]
2026-10-09 Add angled 3D renders of the sensor board
    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
2026-10-10 Add click-in housing CAD: pod, cover, dock, gluing jig (STEP/STL) with 3D viewer
    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
    [cover.step, cover.stl, dock.step, dock.stl, housing_assembly.step, jig.step, jig.stl, pcb_dummy.stl]
2026-10-10 Housing viewer: bundle meshes as models.json for the hosted page
    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
2026-10-11 Housing rev B: squeeze-release latches, force-limited reset, tolerance report
    - Pod: ridge for the dock's spring fingers, USB-C flat sized for cable
    overmolds (13.1 x 7.2), two squeeze latches with overload shoulders,
    board clamped by 3 x M2 screws through its alignment holes.
    - Cover: reset flexure with a force-limiting spring arm and a hard stop on
    the USB-C shell, LED window with light shroud, tuned buzzer chamber,
    battery cage, bezel posts beside the receptacle.
    - Dock: flat key, four spring fingers (zero-play preload), two latch
    windows. Gluing jig: rim-centring frame plus sliding plunger.
    - report.json: every fit at nominal / RSS / worst case, forces, strains,
    masses, balan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
2026-10-14 Housing rev C: twist-lock with ratchet clicks, printable on a P1S in PETG
    Rev B's push-in snap was sized for MJF nylon. Printed in PETG it was
    loose, didn't click and broke: its flexures bent across the layers,
    PETG takes ~1.5 % strain against PA11's 6.7 %, and FDM tolerance ate
    most of the 0.5 mm preload and 1 mm catch.
    Rev C holds the pod by geometry instead:
    - three lugs flush with the lid go up through keyed notches and turn
    30 deg over a solid lip (1.9 mm overlap); helical ramps clamp the lid
    to the plate, with an end stop 10 deg past nominal
    - three in-plane cantilever pawls in the dock click over racks on the
    pod every 3 deg (0.93 % strain per click, along the layers)
    - dock cu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
