davidwwhitney1-lgtm/disctracker/(notices)

Notices in the files:
parts and their libraries:
Seeed XIAO nRF52840, SMD. Pads 19-20 made plated through-holes (DiscTracker). Source: Seeed OPL KiCad library, CC BY-SA 4.0
